CatalinChiprian/phil/(commit log)

2026-02-02 Refactor command properties to use private RelayCommand fields
2026-02-11 Refactor code, add stepper driver fault detection
2026-02-13 Added memory logic. Current position is saved/retrieved to/from memory. Adjusted Column 1 x and y.
2026-02-13 Enable motors in case they are turned off.
2026-02-16 Adjusted coordinates for stepperL/R. Fixed disableMotors func. Added goToOrigin func.
    [final_version.ino]
2026-02-16 Fixed setup autoDisableMotors. Manually disable motors instead of waiting for timer.
    [final_version.ino]
2026-02-19 Add L switch
2026-02-19 setup limit switch L
2026-02-20 Modify calibrate and home position
2026-03-03 Added logic for taking out the well plate.
2026-03-04 Refactor startup flow and modularize UI with DI
    - Introduce dependency injection using Microsoft.Extensions.DependencyInjection for services and view models.
    - Add PortsView and PortsViewModel for port selection and connection at startup; show this window before the main app.
    - Move port selection/connection logic from MainWindowViewModel to PortsViewModel.
    - Refactor navigation and rename pages: BasicControlsPage → BasicControlsView, WellsPage → WellsView.
    - Remove port selection UI from MainWindow; main window now only displays current page content.
    - Update WellsView with button styling for wells grid.
    - Change app icon to applied-nanotechnology.ico.
    - Clean up obsolete code and impro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
2026-03-05 Switch to dark theme and add custom UI styling
    - Change application theme to dark mode and define custom color resources for consistent styling.
    - Add Space Mono font family and apply it across UI elements.
    - Introduce custom styles for Window, TextBlock, ListBox, ListBoxItem, and Button, including new templates and transitions.
    - Redesign PortsView layout: add header, update ListBox item template, and restyle action buttons.
    - Modernize overall UI appearance for improved clarity and consistency.
2026-03-09 Added modified pcb
    [new_pcb_final_version.kicad_pcb]
2026-03-09 Formatted arduino communication for front-end.
2026-03-10 Add Position and Z Axis to sidebar. Add Emergency Stop button.
2026-03-12 Added Position class. Added Z limit for button.
2026-03-12 Added calibration points responsivness.
2026-03-13 Added logic for Organ on Chip switch
2026-03-16 Add CalibrationView
2026-03-17 Add CalibrationPoints print
2026-03-18 Add calibration right sidebar.
2026-03-25 Refactor OoC Plate Type.
2026-03-30 Modified calibration logic. Enabled only specific motors on specific movements.
2026-03-30 Add Calibration DataTable
2026-03-31 Make CalibrationView responsive
2026-04-01 Add Calibrate Home. Move Emergency Btn. Make Disconnect secondary.
2026-04-02 Make Well class dynamic based on CalibrationPoints
2026-04-02 Remove CalibrationRows
2026-04-02 Add record and solve logic for CalibrationView.
2026-04-07 Improved CalibrationView communication and UI update
2026-04-08 Add Calibration Wall
2026-04-08 Replace DockPanel with Grid in CalibrationView
2026-04-08 Add Settings button
2026-04-09 Add Icons. Add General Plate Settings. Delete BasicControlsView
2026-04-09 Add PlateView
2026-04-09 Fixed backward/forward movement. Rewrite caliration home. Rewrite hardcoded wells (stopped at D3)
    [final_version.ino]
2026-04-10 Add 2 pumps. Move Z1 and Z2 to correct drivers. Modify motor test.
    [final_version.ino, motor_test.ino]
2026-04-15 Setup pumps. Add shortcuts for pumps.
    [final_version.ino]
2026-04-24 Set the correct direction
    [final_version.ino]
2026-05-04 Solve memory bugs. Solve conversion bugs.
    [final_version.ino]
2026-05-07 Add Actions logic to GUI and Arduino.
2026-05-11 Switch to less mem variables.
2026-05-13 Fix Process Action. Add print commands.
    [final_version.ino]
2026-05-19 Add PumpsWindow. Add Debug Tools. Create src/inc files for arduino.
2026-05-22 Split arduino code into multiple files.
2026-05-22 Rename switches and remove print after position load.
2026-05-26 Change normal/pump z positions.
2026-05-26 Fix action handling. Fix action processing. Respect the platetype-action relationship.
    [PHIL_Controller.ino, actions.cpp, actions.h, calibration.cpp, commands.cpp, commands.h, eeprom_utils.cpp, hardware.cpp]
2026-05-27 Handle optional pumps in firmware.
2026-05-27 Handle Optional Pump in GUI
2026-05-27 Show correct pump label.
2026-05-28 Add Repeatable checkbox. Pump 1 and Pump 2 optional.
2026-05-29 Skip "None" for PumpsWindow
2026-06-01 Remove custom RelayCommand
2026-06-02 Add ActionItem timer in UI.
2026-06-02 Fix hardcoded well bug.
    Fix calibation bug.
    Add Clear all calibration.
    [actions.cpp, actions.h, calibration.cpp, commands.cpp, commands.h, movement.cpp, well_utils.cpp, well_utils.h]
2026-06-02 Replace XY with WellIndex. Add MediaService for testing purposes.
    [actions.cpp, calibration.cpp, calibration.h, eeprom_utils.cpp, well_utils.cpp, well_utils.h]
2026-06-03 Fix Well_Print. Add CAL_DEL.
    [calibration.cpp, movement.cpp, movement.h]
2026-06-05 Run action only once if only one pump is specified.
2026-06-08 Add Calibration required wall for Medium Exchange.
2026-06-24 Modify origin calibration,
2026-06-29 Calibrate home on startup
2026-06-29 Fix pump order
